ridhoSetia/iot-prediksi-susu/MakanBergizi_Universitas Mulawarman_FP_MaestroFest2026.docx

Sistem Cerdas Penjaminan Mutu Susu Segar Berbasis On-Device TinyML untuk Mitigasi Kerusakan Pascapanen Peternak

Full Paper IoT

MAESTRO FESTIVAL 2026

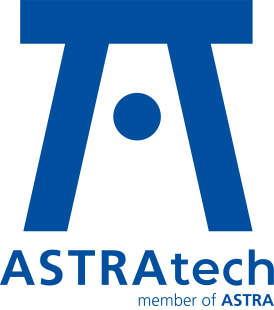
[picture p1: figure]
LOGO ASTRAtech
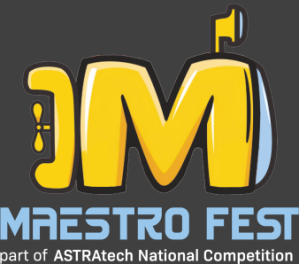
[picture p2: figure]
maestro fest no bckgrnd 1 (2)
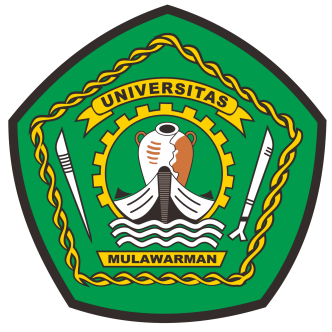
[picture p3: figure]

Subtema:

RESILIENT MOTION SYSTEM

Disusun Oleh :

Makan Bergizi

KETUA | : | Ridho Setiawan (2409106029)
NAMA ANGGOTA 1 | : | Hafizal Asfa Wadhiah (2309106129)
NAMA ANGGOTA 2 | : | Ahnaf Aliyyu (2409106035)

Universitas Mulawarman

Samarinda

2026

LEMBAR PENGESAHAN MAESTRO FESTIVAL 2026

1. | Judul Full Paper | : | Sistem Cerdas Penjaminan Mutu Susu Segar Berbasis On-Device TinyML untuk Mitigasi Kerusakan Pascapanen Peternak
2. | Ketua Tim
| a. Nama Lengkap | : | Ridho Setiawam
| b. NIM | : | 2409106029
| c. Program Studi | : | Informatika
| d. E-mail | : | ridho.setiawan24406@gmail.com
3. | Nama Anggota Tim 1 | : | Hafizal Asfa Wahdiah (2309106129)
4. | Nama Anggota Tim 2 | : | Ahnaf Aliyyu (2409106035)
5. | Dosen Pembimbing
| a. Nama Lengkap & Gelar | : | Anton Prafanto, S.Kom., MT.
| b. NIDN | : | 0022109301
| c. E-mail | : | antonprafanto@unmul.ac.id
6. | Nama Institusi | : | Universitas Mulawarman

Samarinda, 24 September 2026

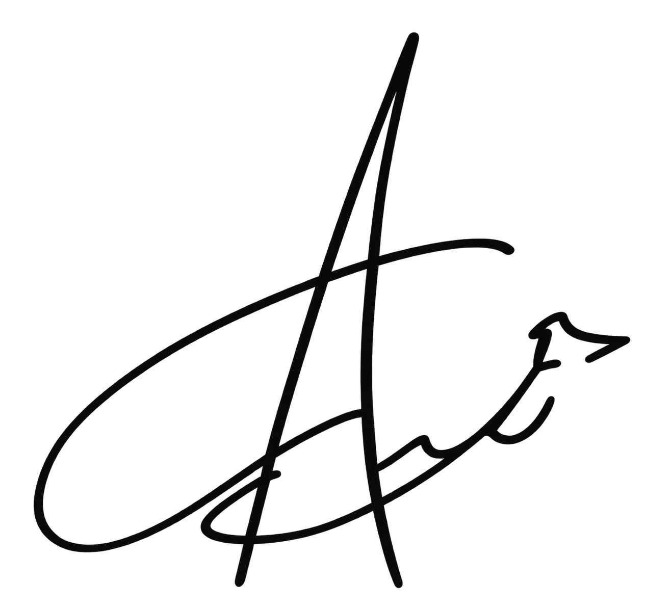
[picture p4: figure]
ttd-anton
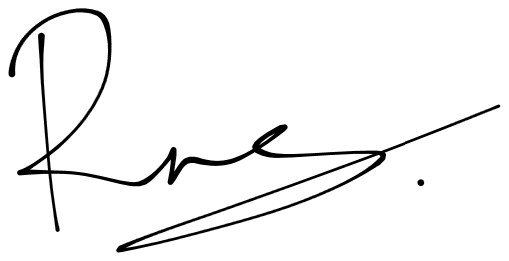
[picture p5: figure]
ttd-ridho

Dosen Pembimbing (Anton Prafanto, S.Kom., MT.) NIDN. 0022109301 | Ketua Tim (Ridho Setiawan) NIM. 2409106035

Kepala Departemen Kemahasiswaan

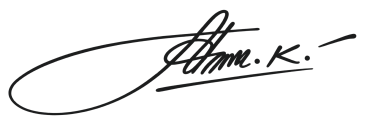
[picture p6: figure]
ttd-awang

(Awang Harsa Kridalaksana, S.Kom., M.Kom.)

NIDN. 0029127302

KATA PENGANTAR

Puji syukur senantiasa penulis panjatkan atas segala rahmat dan karunia-Nya, sehingga karya full paper yang berjudul "Sistem Cerdas Penjaminan Mutu Susu Segar Berbasis On-Device TinyML untuk Mitigasi Kerusakan Pascapanen Peternak" ini dapat diselesaikan dengan baik. Penulisan karya ini bertujuan untuk memberikan solusi aplikatif berbasis Internet of Things (IoT) dan kecerdasan buatan dalam mengatasi permasalahan kritis penurunan kualitas susu segar di tingkat peternak, sekaligus berpartisipasi dalam ajang MAESTRO FESTIVAL 2026.

Penulis menyadari bahwa proses penyusunan karya ini tidak terlepas dari dukungan, bimbingan, serta kontribusi berbagai pihak. Oleh karena itu, penulis menyampaikan ucapan terima kasih yang sebesar-besarnya kepada dosen pembimbing yang telah meluangkan waktu dan pemikirannya, serta kepada seluruh anggota tim yang telah berkolaborasi secara sinergis mulai dari tahap perancangan, pengujian laboratorium, hingga penyusunan laporan. Harapan penulis, gagasan inovatif ini dapat direalisasikan dan membawa dampak positif, khususnya dalam meningkatkan efisiensi dan transparansi rantai pasok industri susu perah di Indonesia.

Samarinda, 12 September 2026

Penyusun

( Ridho Setiawan)

NIM. 2409106029

LEMBAR PERNYATAAN ORISINALITAS KARYA

Judul Full Paper | : | Sistem Cerdas Penjaminan Mutu Susu Segar Berbasis On-Device TinyML untuk Mitigasi Kerusakan Pascapanen Peternak
Nama Ketua | : | Ridho Setiawan
Nama Anggota | : | 1. Hafizal Asfa Wahdiah 2. Ahnaf Aliyyu
Nama Institusi | : | Universitas Mulawarman

Kami yang bertanda tangan di bawah ini menyatakan bahwa karya dengan judul sebagaimana tercantum di atas merupakan karya orisinal yang dibuat oleh peserta dan belum pernah dipublikasikan maupun diikutsertakan dalam perlombaan sejenis di luar kegiatan Maestro Festival 2026 yang diselenggarakan oleh Himpunan Mahasiswa Mekatronika Politeknik ASTRA.

Demikian pernyataan ini kami buat dengan sebenar-benarnya. Apabila di kemudian hari terbukti bahwa pernyataan ini tidak benar, kami bersedia menerima sanksi berupa pembatalan keikutsertaan serta pencabutan hasil kejuaraan.

Samarinda, 12 September 2026

Ketua Tim

( Ridho Setiawan)

NIM. 2409106029

DAFTAR ISI

LEMBAR PENGESAHAN...........................................................................................2

KATA PENGANTAR...................................................................................................3

LEMBAR PERNYATAAN ORISINALITAS KARYA...............................................4

DAFTAR ISI.................................................................................................................5

DAFTAR TABEL.........................................................................................................6

ABSTRAK....................................................................................................................7

I. LATAR BELAKANG...............................................................................................7

II. TUJUAN DAN SOLUSI..........................................................................................7

III. LANDASAN TEORI..............................................................................................7

IV. KONSEP PERANCANGAN..................................................................................8

1. Arsitektur Perangkat Keras (Hardware)..............................................................8

2. Arsitektur Perangkat Lunak dan Ekstraksi Fitur (Software & TinyML)............9

3. Alur Kerja (Flowchart)........................................................................................8

4. Susunan Tim.......................................................................................................8

5. Rencana Anggaran Biaya...................................................................................8

6. Timeline Pembuatan Karya................................................................................9

V. KESIMPULAN......................................................................................................10

VI. DAFTAR PUSTAKA...........................................................................................10

DAFTAR TABEL

Tabel 1. Rencana Anggaran Biaya.....................................................................10

Tabel 2. Timeline Pembuatan Karya..................................................................11

Sistem Cerdas Penjaminan Mutu Susu Segar Berbasis On-Device TinyML untuk Mitigasi Kerusakan Pascapanen Peternak

Ridho Setiawan, Hafizal Asfa Wahdiah, Ahnaf Aliyyu

Universitas Mulawarman

ridho.setiawan24406@gmail.com

### ABSTRAK

Karya ini mengusulkan alat uji portabel berbasis ESP32-S3 dan TinyML untuk mengatasi kerugian finansial peternak akibat kerusakan susu segar pascapemerahan. Dengan mengintegrasikan sensor konduktivitas listrik (EC) dan suhu, alat ini mampu mengklasifikasikan mutu susu (Grade A/B/C) serta memprediksi sisa masa simpan kurang dari 3 detik secara offline. Sistem ini didukung arsitektur offline-first yang menyimpan data secara lokal dan menyinkronkannya ke cloud, sehingga dapat mengoptimalkan logistik dan menghadirkan transparansi pengujian.

### I. LATAR BELAKANG

Susu sapi segar sangat mudah rusak akibat iklim tropis dan minimnya fasilitas pendingin, sehingga sering ditolak oleh pos penampungan dan merugikan peternak. Mengingat uji konvensional sering terlambat mendeteksi kerusakan, diperlukan alat uji portabel berbasis TinyML untuk mendeteksi penurunan mutu dan sisa masa simpan susu secara instan di peternakan.

### II. TUJUAN DAN SOLUSI

Berdasarkan latar belakang tersebut, tujuan dan solusi utama dari inovasi ini adalah:

- Mitigasi Kerugian Finansial: Mendeteksi penurunan mutu susu sejak dini untuk mengurangi risiko penolakan dan kerugian peternak.
- Komputasi Edge Mandiri: Inferensi TinyML berjalan langsung pada mikrokontroler ESP32-S3 tanpa kebergantungan pada koneksi internet.
- Pengujian Instan dan Higienis: Alat uji handheld portabel yang membaca kondisi biokimia susu dalam waktu kurang dari 3 detik tanpa reagen kimia.
- Transparansi dan Optimasi Logistik: Indikator digital objektif (OLED/LED) menjaga keselarasan hasil uji, sekaligus data offline-first membantu koperasi memprioritaskan rute penjemputan susu secara dinamis (Rani et al., 2025).

### III. LANDASAN TEORI

1. Kinetika Asam Laktat dan Konduktivitas Listrik (EC) Susu

Aktivitas bakteri asam laktat memicu pelepasan ion hidrogen yang meningkatkan nilai konduktivitas listrik (EC) susu, sehingga perubahan EC ini dapat digunakan sebagai biomarker untuk memprediksi penurunan pH dan sisa masa simpan (Kusuma & Wibowo, 2023; Rukmana et al., 2021).

2. Tiny Machine Learning (TinyML) dan Kuantisasi Model

Melalui FP32 berbasis C++, model TinyML dapat direduksi secara ekstrem tanpa kehilangan akurasi, memungkinkan mikrokontroler ESP32-S3 untuk memprediksi mutu dan umur susu secara mandiri dan real-time (Ramesh et al., 2024; Ray, 2022; Saha et al., 2022).

3. Arsitektur Sinkronisasi Offline-First

Arsitektur offline-first memastikan sistem berfungsi penuh tanpa koneksi internet. Mikrokontroler menyusun payload data ke penyimpanan lokal Flash Internal ESP32-S3 terlebih dahulu; ketika Wi-Fi tersedia, data dikirim ke endpoint API server cloud dan dihapus dari antrean lokal setelah menerima respons sukses (HTTP 200 OK) (Yulianto, 2025; Sharma, 2023; Barde & Adkar, 2026).

### IV. KONSEP PERANCANGAN

Perancangan sistem menggabungkan integrasi perangkat keras sensor presisi, model inferensi teroptimasi, serta arsitektur basis data untuk pencatatan kualitas rantai pasok.

#### 1. Arsitektur Perangkat Keras (Hardware)

Perangkat genggam berbasis ESP32-S3 ini ditenagai baterai Li-Po dan menggunakan probe konduktivitas Stainless Steel 316 serta sensor suhu RTD PT100, dengan hasil pengujian yang langsung ditampilkan melalui layar OLED dan indikator LED.

#### 2. Arsitektur Perangkat Lunak dan Ekstraksi Fitur (Software & TinyML)

Sistem membaca sinyal eksitasi AC dari elektroda untuk memperoleh nilai hambatan cairan (R_liquid) dan EC mentah, dikompensasi termal ke suhu standar 25°C (EC_25) memanfaatkan pembacaan RTD PT100. Empat parameter (Suhu, R_liquid, EC_raw, EC_25) diproses on-device oleh model Multi-Task MLP berbasis C++ (FP32) yang memanfaatkan akselerasi FPU ESP32-S3, menghasilkan klasifikasi mutu (Grade A, B, C) dan estimasi sisa masa simpan (0-360 menit) dalam waktu kurang dari 3 detik (Paul et al., 2024).

#### 3. Alur Kerja (Flowchart)

Alur sistem dimulai dari inisialisasi sensor, pembacaan probe, inferensi TinyML, penyimpanan payload JSON, hingga pengecekan ketersediaan Wi-Fi untuk sinkronisasi batch (Lampiran 1).

#### 4. Susunan Tim

- Ketua Tim: Manajemen proyek, perancangan arsitektur software, optimasi model TinyML, dan integrasi backend, cloud, serta dashboard IoT.
- Anggota 1: Hardware dan firmware, desain sirkuit, enclosure 3D, serta kode C++ untuk akuisisi sinyal eksitasi AC dan kontrol I/O.
- Anggota 2: Riset biokimia, pengumpulan sampel susu di lapangan, uji pembanding (uji alkohol), dan pelabelan dataset untuk pelatihan AI.

#### 5. Rencana Anggaran Biaya

No | Nama Item | Jumlah | Biaya Satuan | Total Biaya
1 | ESP32-S3 | 1 Buah | 150.000 | 150.000
2 | Sensor RTD PT100 + MAX31865 | 1 Buah | 170.000 | 170.000
3 | kawat SS 316 | 1 Meter | 10.000 | 10.000
4 | OLED 0.96 | 1 Buah | 50.000 | 50.000
5 | Baterai Li-Po + Modul Charger | 1 Set | 65.000 | 65.000
6 | Larutan Kalibrasi EC | 4 Buah | 29.000 | 116.000
7 | Bahan Uji (Susu, Alkohol 70%, Aquades) | Paket | 62.000 | 62.000
8 | Penyewaan server (VPS/Cloud) | 1 Bulan | 150.000 | 150.000
9 | Transportasi | 5 Liter | 17.000 | 90.000
Total | | | | 863.000.

#### 6. Timeline Pembuatan Karya

Realisasi inovasi ini direncanakan melalui 4 bulan, dengan distribusi beban kerja (PIC) sebagai berikut:

No | Timeline Pembuatan Karya | Bulan | | | | PIC
| | 1 | 2 | 3 | 4
1 | Analisis kebutuhan hardware, skematik ESP32-S3, desain 3D enclosure, dan pengadaan komponen. | ✓ | | | | Ketua Tim & Anggota 1
2 | Pembuatan probe elektroda SS316, modul pengondisi sinyal, dan pemrograman eksitasi AC & MicroSD. | ✓ | ✓ | | | Anggota 1
3 | Pengambilan sampel susu berkala, uji ground truth (uji alkohol), dan pelabelan data kinetika ion. | | ✓ | | | Anggota 2
4 | Ekstraksi fitur (EC25, laju ΔEC/Δt), pelatihan model, kuantisasi INT8, dan deployment ke ESP32-S3. | | ✓ | ✓ | | Ketua Tim & Anggota 2
5 | Pembangunan database server, sinkronisasi offline-first, dan visualisasi peta mutu pada dashboard. | | | ✓ | | Ketua Tim
6 | Uji coba lapangan, pengujian toleransi jaringan, penyusunan panduan, dan laporan akhir. | | | | ✓ | Seluruh Anggota Tim

V. KESIMPULAN

Inovasi ini mengoptimalisasi pengujian mutu susu dari reaktif (uji alkohol) menjadi prediktif berbasis TinyML. ESP32-S3 dengan model FP32 C++ mampu mengukur pergerakan ion secara cepat (< 3 detik) tanpa bergantung pada internet, dengan biaya produksi prototipe yang terjangkau. Arsitektur offline-first menghapus blind-spot transparansi logistik industri susu perah, dan bila diadopsi secara masif berpotensi mencegah kerugian tonase susu serta memaksimalkan pendapatan peternak tradisional.

### VI. DAFTAR PUSTAKA

Barde, P., & Adkar, P. (2026). Offline-first architecture: Design principles, synchronization mechanisms, and real-world applications. Iconic Research and Engineering Journals, 9(11), 2847–2854.

Kusuma, H., & Wibowo, A. (2023). Analisis kinetika bakteri asam laktat dan korelasinya terhadap konduktivitas listrik susu segar tropis. Jurnal Teknologi Pangan dan Hasil Pertanian, 8(1), 112–120.

Paul, J., Schmid, L., Klaiber, M., & Rössle, M. (2024). Extraction of measurement device information on an ESP32 microcontroller: TinyML for image processing. Procedia Computer Science, 246, 2002–2011.

Ramesh, S., dkk. (2024). TinyML: Edge intelligence for sensor data classification in precision agriculture. Journal of Internet of Things and Edge Computing, 14(2), 45–56.

Rani, R., Deshpande, N., Singh, B., Kumar, S., Kumar, V., & Singh, G. (2025). From farm to fork: How AI and IoT are transforming dairy supply chains—A review of current practices and future prospects. Plant Archives, 25(1), 2578–2588.

Ray, P. P. (2022). A review on TinyML: State-of-the-art and prospects. Journal of King Saud University – Computer and Information Sciences, 34(4), 1595–1623.

Rukmana, M. S., Rakhmatsyah, A., & Wardana, A. A. (2021). Mastitis detection system in dairy cow milk based on fuzzy inference system using electrical conductivity and power of hydrogen sensor value. EMITTER International Journal of Engineering Technology, 9(1), 154–168.

Saha, S. S., Sandha, S. S., & Srivastava, M. (2022). Machine learning for microcontroller-class hardware: A review. IEEE Sensors Journal, 22(22), 21362–21390.

Sharma, P. (2023). Offline first architecture in real-time applications. International Journal of Management, IT & Engineering, 13(12), 26–30.

Yulianto, R. (2025). Implementasi sinkronisasi database offline-first berbasis Node.js dan protokol HTTP pada perangkat pemantauan terpencil. Prosiding Konferensi Nasional Teknik Informatika, 88–94.

LAMPIRAN 1

Diagram Alur Sistem

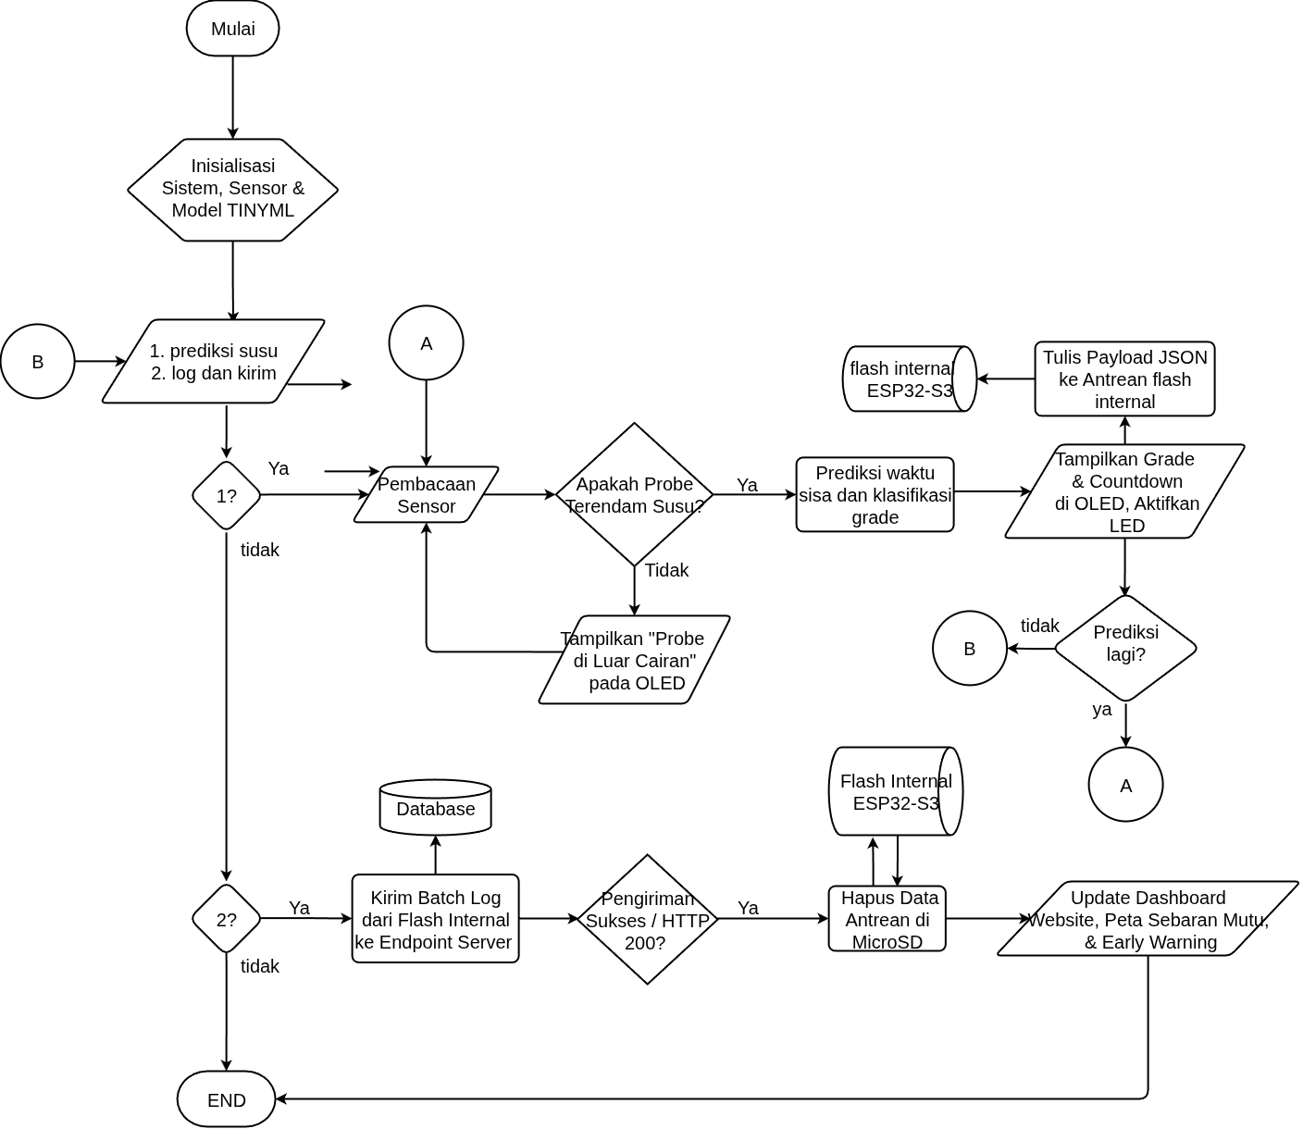
[picture p7: figure]

Lampiran 2

HASIL TURNITIN

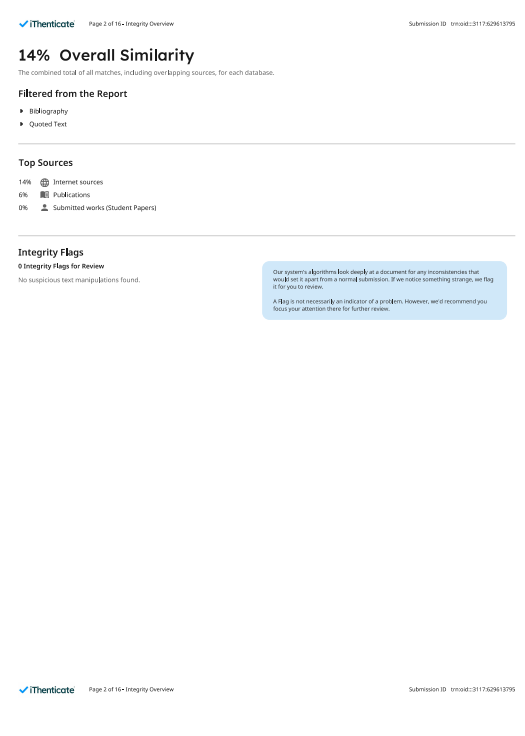
[picture p8: figure]
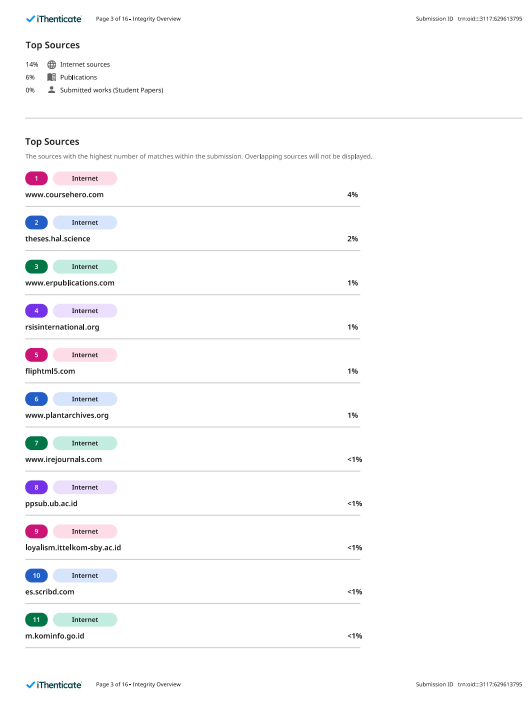
[picture p9: figure]
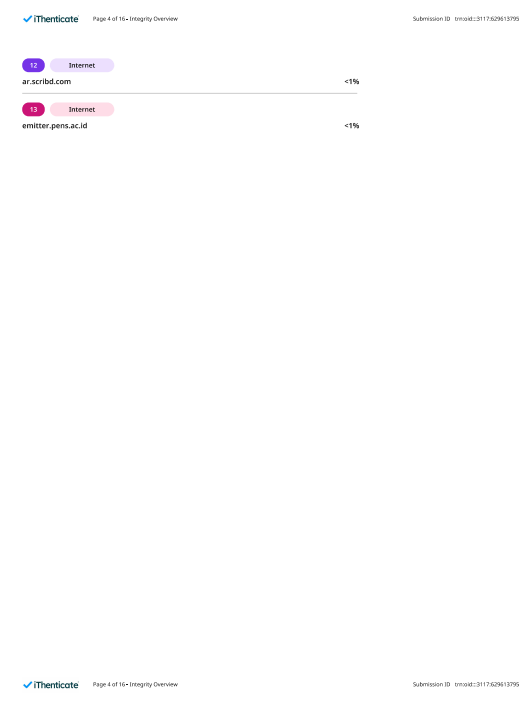
[picture p10: figure]

Lampiran 3

Tampilan Dashboard

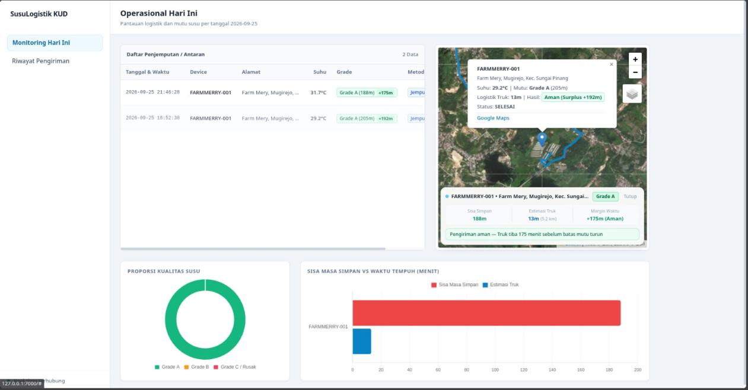
[picture p11: figure]
WhatsApp Image 2026-09-25 at 20.48.19
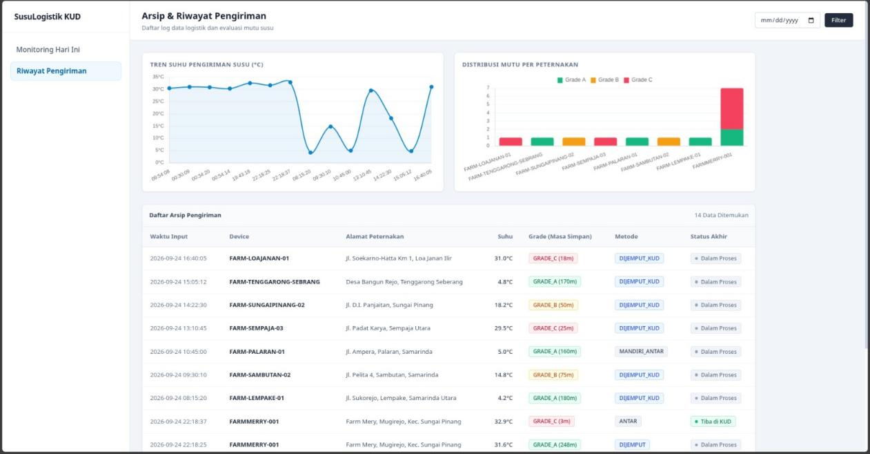
[picture p12: figure]
WhatsApp Image 2026-09-25 at 20.48.18

Lampiran 4

Foto Hasil Alat yang Dibuat

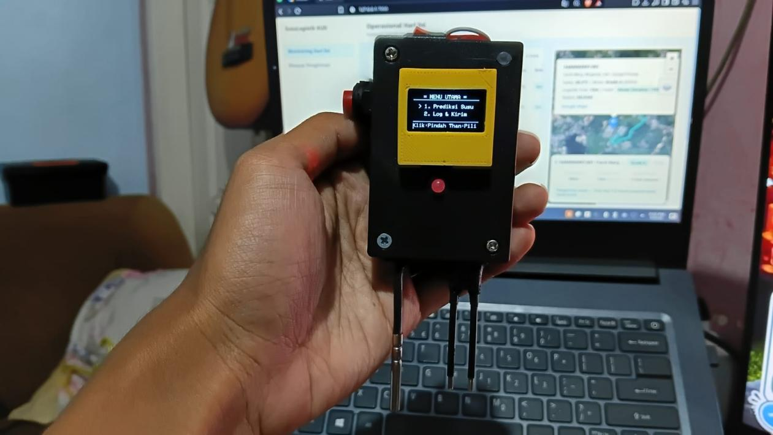
[picture p13: figure]
WhatsApp Image 2026-09-25 at 20.50.15
