ridhoSetia/iot-prediksi-susu/pelatihan/arsitektur_model.png

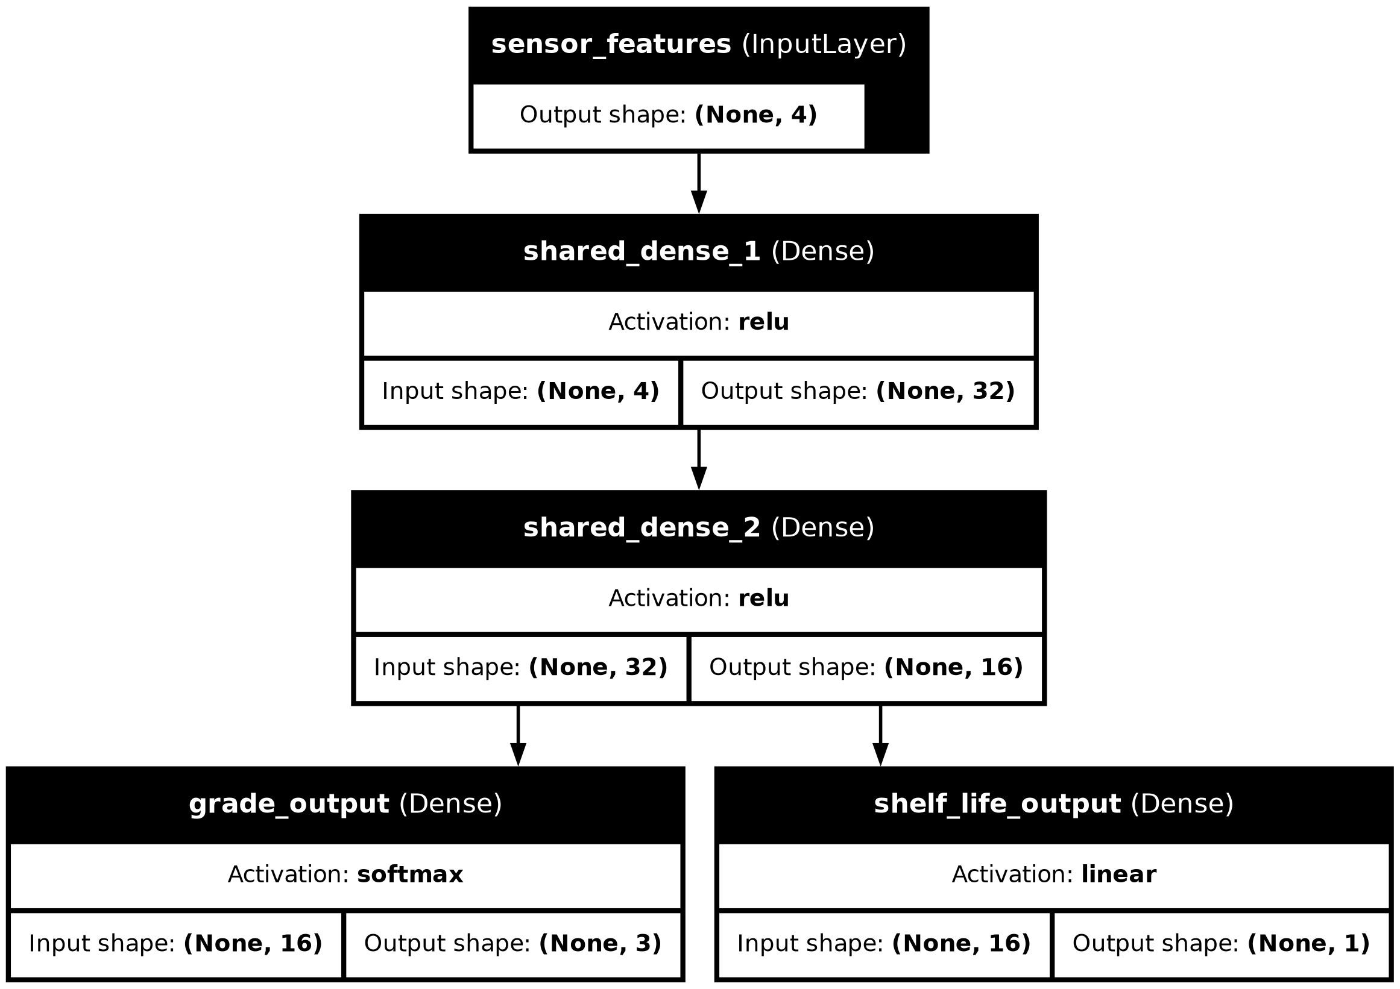
pelatihan/arsitektur_model.png
