ridhoSetia/iot-prediksi-susu/prediksi-susu/milk_model_weights.h

#ifndef MILK_MODEL_WEIGHTS_H
#define MILK_MODEL_WEIGHTS_H

#include <Arduino.h>
#include <math.h>

// Arsitektur Jaringan: 4 -> 32 -> 16 -> [3 (Grade), 1 (Shelf-life)]
const int H1_DIM = 32;
const int H2_DIM = 16;

// Layer 1 (Dense 32)
const float MODEL_W1[4][32] = {
  { 0.2745643f, 0.0821565f, -0.5741562f, 0.4003191f, -0.0152084f, -0.0696939f, 0.0057769f, -0.0227417f, 0.4357204f, -0.4858727f, 0.0693861f, -0.2696523f, 0.1206525f, 0.3548469f, -0.3666714f, -0.6949663f, 0.3585503f, -0.1223306f, 0.0693913f, -0.1771130f, 0.4787246f, 0.2457769f, 0.0809147f, -0.3573563f, 0.3271763f, 0.1973461f, -0.0573121f, 0.1165358f, 0.1379324f, 0.3720472f, 0.4862759f, -0.3843890f },
  { -0.1124338f, -0.3325499f, 0.9475888f, -0.1590006f, -0.0098977f, -0.1778497f, 0.5152540f, 0.1082939f, 0.1878604f, -0.4271300f, 0.0825959f, 0.4442181f, 0.4300030f, -0.1325840f, -0.2212862f, 0.2830133f, -0.1383523f, -0.0096000f, -0.2259859f, -0.3474849f, 0.4113483f, -0.0055020f, -0.3645398f, -0.0320375f, -0.3639307f, -1.1692253f, 0.3474270f, 0.3413028f, -0.0208761f, -0.0697045f, -0.0687720f, -0.0373972f },
  { -0.1474491f, 0.3889062f, 0.2311659f, -0.3427987f, 0.0446426f, -0.3966931f, 0.2281111f, -0.2098700f, -0.1172032f, 0.2232544f, 0.0904503f, -0.3533962f, 0.0392343f, -0.0073897f, -0.0606219f, -0.1645066f, 0.3747666f, -0.2378614f, -0.2702254f, -0.3350100f, 0.4101810f, 0.3972148f, -0.0839373f, 0.0355549f, 0.2565565f, 0.3793738f, 0.3798447f, 0.0400667f, -0.3158880f, 0.5167478f, -0.2633650f, -0.3694920f },
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
  float x[4] = { in_suhu, in_rohm, in_ecraw, in_ec25 };

  // 1. Forward Pass Layer 1 (ReLU)
  float h1[32];
  for (int j = 0; j < 32; j++) {
    float sum = MODEL_B1[j];
    for (int i = 0; i < 4; i++) sum += x[i] * MODEL_W1[i][j];
    h1[j] = (sum > 0.0f) ? sum : 0.0f;
  }

  // 2. Forward Pass Layer 2 (ReLU)
  float h2[16];
  for (int j = 0; j < 16; j++) {
    float sum = MODEL_B2[j];
    for (int i = 0; i < 32; i++) sum += h1[i] * MODEL_W2[i][j];
    h2[j] = (sum > 0.0f) ? sum : 0.0f;
  }

  // 3. Head Klasifikasi Grade (Argmax)
  float best_val = -1e9f;
  int best_idx = 0;
  for (int j = 0; j < 3; j++) {
    float sum = MODEL_B_GRADE[j];
    for (int i = 0; i < 16; i++) sum += h2[i] * MODEL_W_GRADE[i][j];
    if (sum > best_val) {
      best_val = sum;
      best_idx = j;
    }
  }
  if (best_idx == 0) out_grade = "GRADE_A";
  else if (best_idx == 1) out_grade = "GRADE_B";
  else out_grade = "GRADE_C";

  // 4. Head Regresi Sisa Waktu Simpan (Linear)
  float shelf_sum = MODEL_B_SHELF[0];
  for (int i = 0; i < 16; i++) shelf_sum += h2[i] * MODEL_W_SHELF[i][0];
  if (shelf_sum < 0.0f) shelf_sum = 0.0f;
  
  int minutes = (int)round(shelf_sum * max_minutes);
  out_shelf_life_min = constrain(minutes, 0, (int)max_minutes);
}

#endif // MILK_MODEL_WEIGHTS_H
