ridhoSetia/iot-prediksi-susu/(commit log)

2026-09-20 kalibrasi 2 titik sensor ec, button push logic, flash internal untuk data
2026-09-20 perbaiki logika oled memastikan oled nyala dan perbaiki masalah pembacaan suhu anomali, max31865 (sekarang menggunakan 2wire), menambah led rgb
2026-09-21 feat(firmware): implementasi FSM menu OLED dan kontrol dual-action button
    - Menambahkan Finite State Machine (FSM) dengan 3 menu utama: Prediksi, Lihat & Kirim, dan Ambil Data
    - Menerapkan mekanisme dual-action button (klik singkat untuk navigasi, tahan untuk eksekusi)
    - Menambahkan visualisasi hold progress bar pada display OLED SSD1306
    - Mengintegrasikan alur 5-burst sampling otomatis ke berkas dataset_susu.csv pada LittleFS
    - Memperbarui antarmuka OLED dan logger Flash untuk mode standby, proses inferensi, dan sinkronisasi
2026-09-21 feat: integrasi FSM menu OLED, selector sample_id, dan monitoring log LittleFS
    - Implementasi sistem navigasi 3 menu berbasis FSM dan tombol dual-action
    - Tambah seleksi sample_id otomatis pada logging dataset_susu.csv (5-burst sampling)
    - Perbarui tampilan layar data untuk menampilkan kuantitas file CSV dan ketersediaan JSON prediksi
2026-09-23 feat: implement native C++ TinyML prediction and streamline field firmware
    - Data Pipeline & Modeling:
    * Remove redundant 'alcohol_test' column and focus on bio-physical features
    * Apply stratified 80:20 split before targeted convex interpolation for Grade B
    * Cap shelf-life regression target at 360 minutes to eliminate gradient explosion
    * Train 4->24->12 multi-task MLP achieving 94.12% accuracy and 9.13 min MAE
    - ESP32-S3 Firmware:
    * Strip out CSV acquisition, burst logging, and Google Sheets dependencies
    * Deploy model via zero-dependency C++ forward-pass (milk_model_weights.h)
    * Resolve macro conflicts with Arduino binary.h by renaming weights to MODEL_*
    * Simplify FSM t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
2026-09-24 feat: tuntaskan sistem prediksi mutu susu siap produksi dengan TinyML native
    - Pipeline Machine Learning:
    * Atasi ketimpangan skala gradien lewat pembobotan L1 MAE (cls: 1.0, reg: 12.0)
    * Terapkan interpolasi lokal k-NN (k=3) untuk menjaga klaster Grade B
    * Capai performa optimal: akurasi 97.06% dan MAE 4.07 menit
    - Firmware ESP32-S3:
    * Terapkan inferensi C++ native bebas dependensi (arsitektur 32->16 FP32)
    * Sederhanakan FSM ke 2 menu utama: Prediksi Real-Time dan Sinkronisasi FastAPI
    * Integrasikan proteksi probe kering dan penyimpanan offline persisten LittleFS
    * Dukung pemilihan opsi distribusi penjemputan (DIJEMPUT / ANTAR)
    - Dokumentasi:
    * Perbarui blueprint teknis RE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
2026-09-27 docs: lengkapi dokumentasi dan penjelasan teknis tiap cell di notebook
2026-10-06 refactor: ubah keseluruhan website jadi menggunakan docker, nginx, dan juga menambahkan code untuk test_bencmark alat
    [dataset_susu_labeled.csv]
2026-10-26 fix: perbaiki masalah 404 karena esp32 memakai http bukan https
2026-10-26 fix: error 500 karena data yang dikirim dari esp32 kolomnya tidak sesuai dengan yang ada di db website
2026-10-26 fix: perbaiki estimasi sisa waktu jadi 0 setelah navigasi riwayat ke dasbor
    Saat halaman dasbor di-reload (misal setelah pindah ke halaman riwayat dan balik),
    data dari server tidak memiliki _receivedAt sehingga getEffectiveItemData()
    menghitung elapsedMinutes dari created_at. Jika data sudah beberapa jam lalu,
    elapsedMinutes bisa melebihi _initial_sisa sehingga currentSisa menjadi 0.
    Fix: pre-hitung _initial_sisa yang sudah terkoreksi sejak created_at hingga
    pageLoadTime, lalu set _receivedAt = pageLoadTime untuk semua item yang dimuat
    dari server. Countdown sisa waktu kini konsisten baik via WebSocket maupun reload.
2026-10-26 fix: koreksi sisa_waktu_menit di server sebelum dikirim ke client
    Akar masalah: getEffectiveItemData() di client menghitung elapsed time dari
    created_at menggunakan new Date() yang bisa tidak konsisten antarlingkungan.
    Saat halaman pertama dibuka via WebSocket _receivedAt di-set sehingga tampak
    benar, namun setelah reload (navigasi riwayat → dasbor) _receivedAt hilang
    dan kalkulasi dari created_at dipakai, menghasilkan sisa waktu 0.
    Fix di server (main.py): sisa_waktu_menit sudah dikoreksi waktu nyata oleh
    Python sebelum di-render ke template — menghilangkan ketergantungan client
    pada parsing created_at yang rawan masalah timezone.
    Fix di client (index.html): _initial_sisa dan _receive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
